justinborromeo/me-321-shaft-design/Screenshots/Top View Full Assembly.PNG

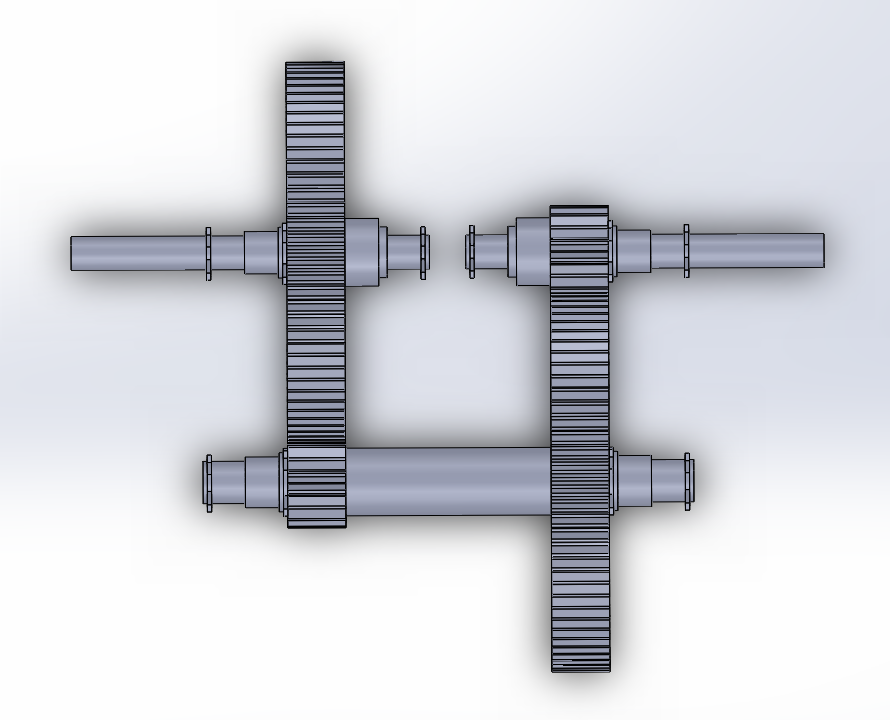
Screenshots/Top View Full Assembly.PNG
