justinborromeo/me-321-shaft-design/Screenshots/Isometric View.PNG

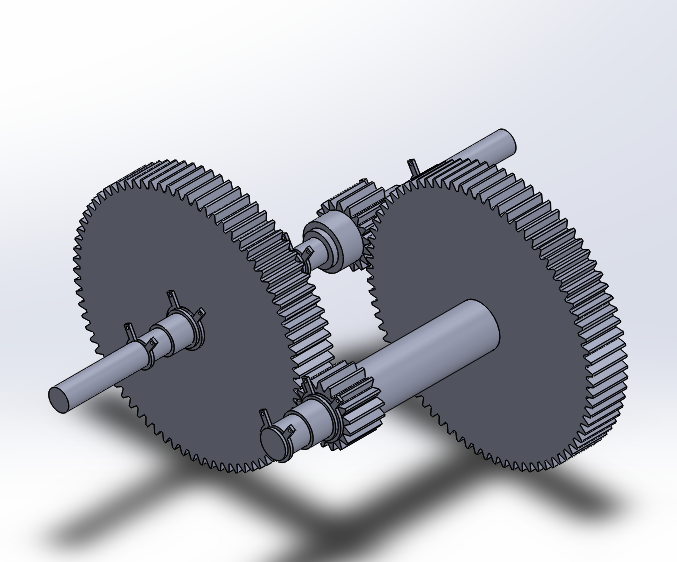
Screenshots/Isometric View.PNG
