justinborromeo/me-321-shaft-design/Screenshots/Front View Dimensions.PNG

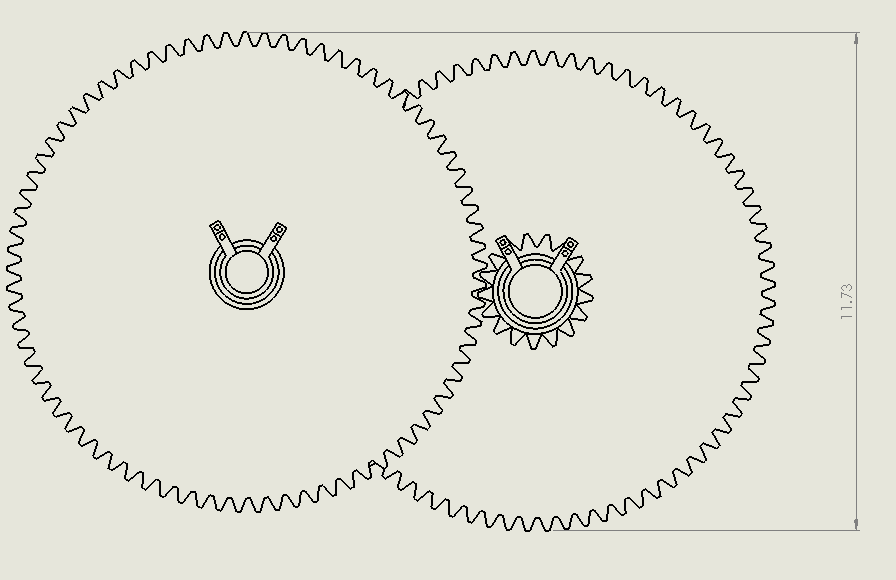
Screenshots/Front View Dimensions.PNG
