justinborromeo/me-321-shaft-design/Screenshots/Isometric View Drawing.PNG

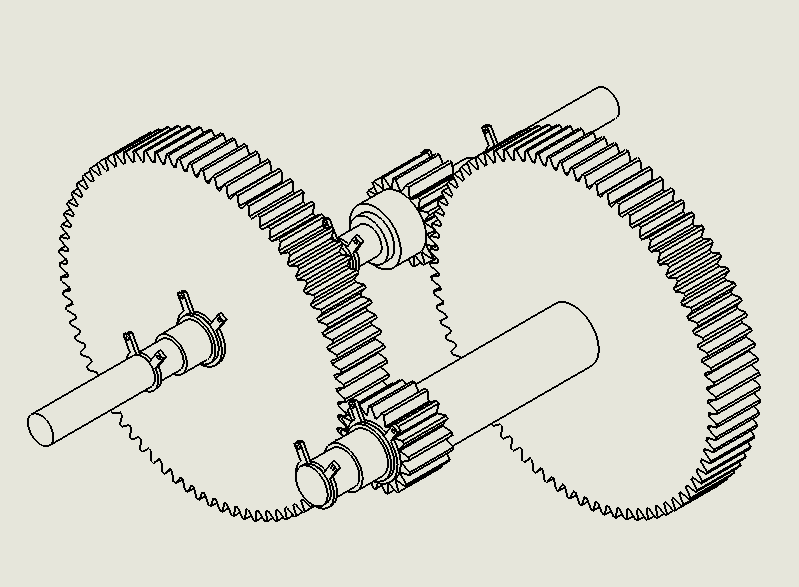
Screenshots/Isometric View Drawing.PNG
