justinborromeo/me-321-shaft-design/Screenshots/Parts/Common Keyset Drawing.PNG

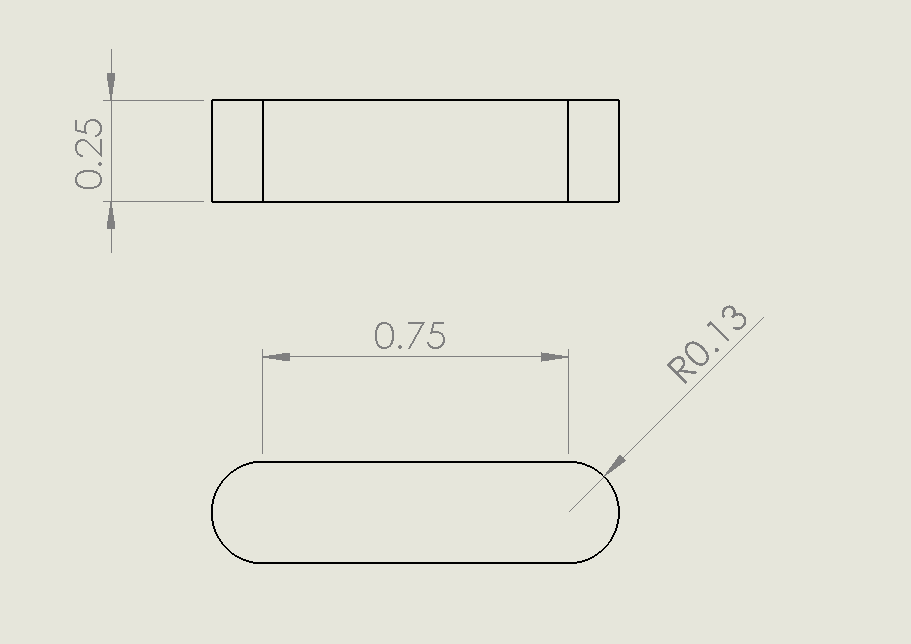
Screenshots/Parts/Common Keyset Drawing.PNG
