justinborromeo/me-321-shaft-design/Screenshots/Parts/Input Output Shafts/InputOutputShaftDrawing.PNG

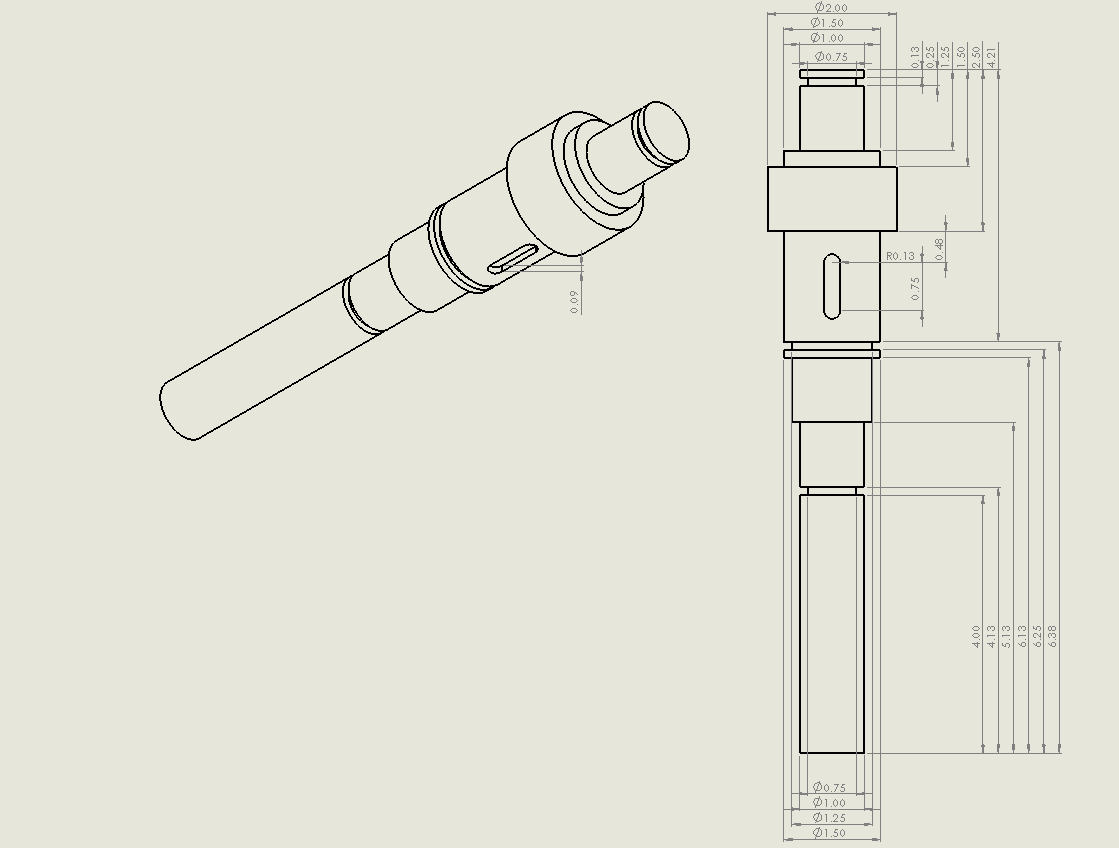
Screenshots/Parts/Input Output Shafts/InputOutputShaftDrawing.PNG
