justinborromeo/me-321-shaft-design/Screenshots/Parts/Transfer Shaft/Transfer Shaft Zoom Bottom.PNG

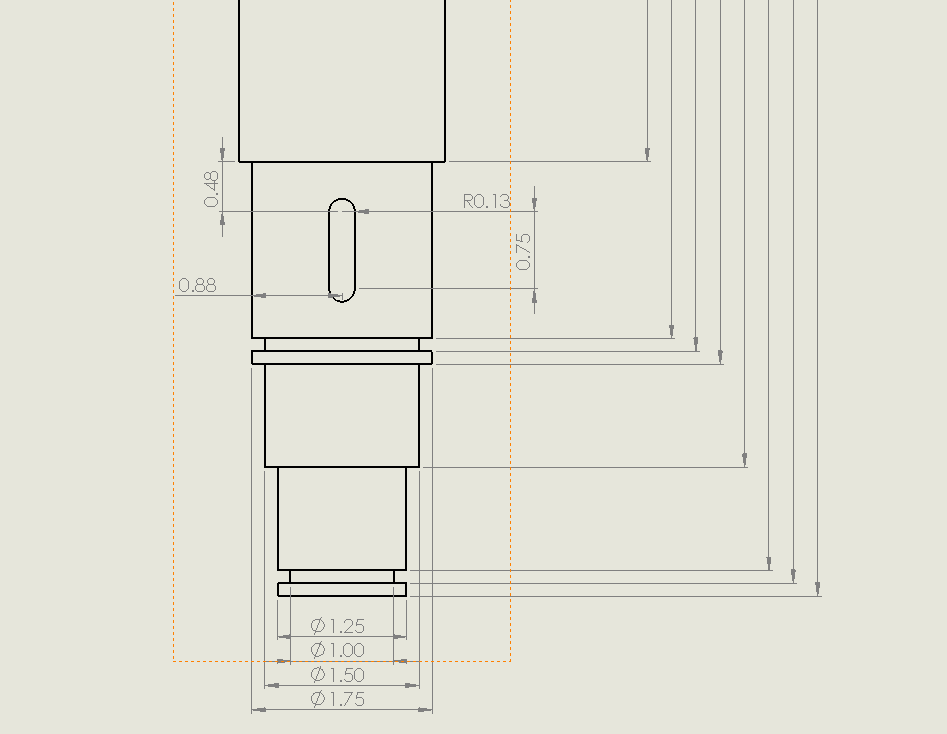
Screenshots/Parts/Transfer Shaft/Transfer Shaft Zoom Bottom.PNG
