justinborromeo/me-321-shaft-design/Screenshots/Parts/Transfer Shaft/Transfer Shaft Zoom Top.PNG

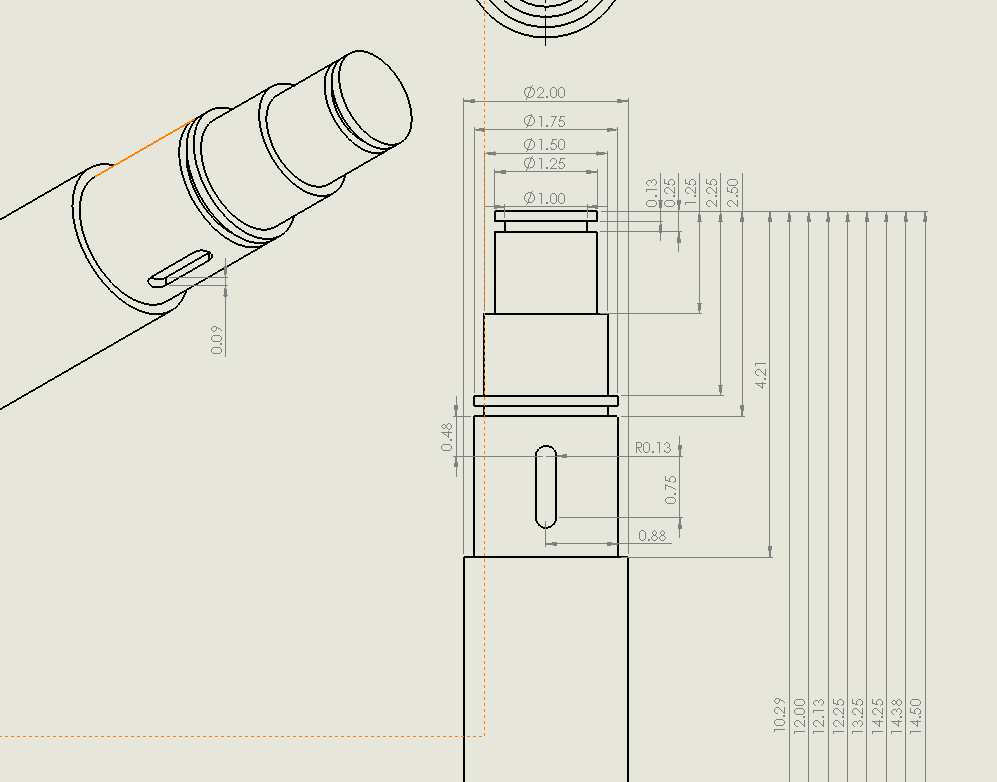
Screenshots/Parts/Transfer Shaft/Transfer Shaft Zoom Top.PNG
