justinborromeo/me-321-shaft-design/Input-Output Shaft/Input Output Shaft Assembly.SLDASM

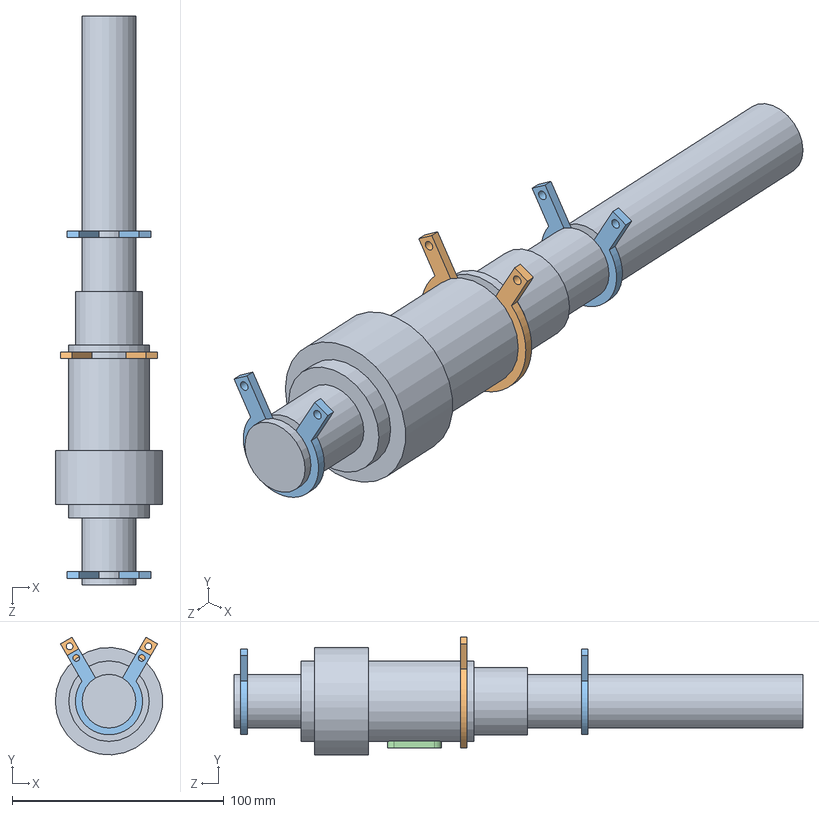
[picture p32: CAD file, 2019-07-24]
Input-Output Shaft/Input Output Shaft Assembly.SLDASM
50.8 x 55.6 x 269.0 mm
Input Output Shaft
Retaining Ring Input Output Shaft Gear
Retaining Ring Input Output Shaft Walls x 2
Keyset Common
