justinborromeo/me-321-shaft-design/InputShaftCompleteAssembly.SLDASM

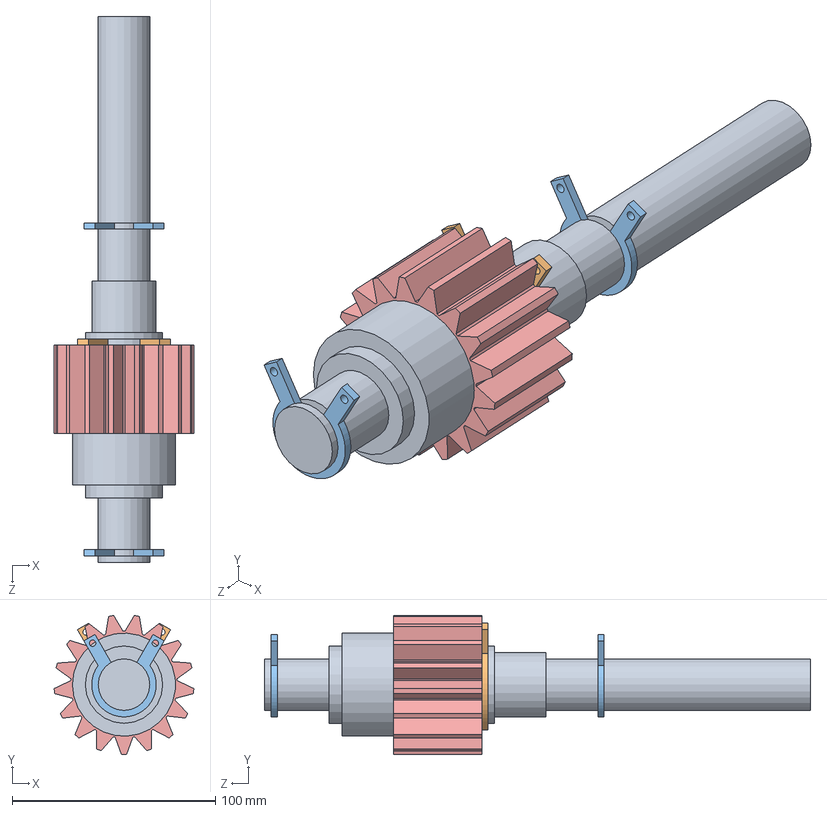
[picture p33: CAD file, 2019-07-24]
InputShaftCompleteAssembly.SLDASM
68.8 x 68.5 x 269.0 mm
Input Output Shaft
Retaining Ring Input Output Shaft Gear
Retaining Ring Input Output Shaft Walls x 2
Keyset Common
Pinion Input
