justinborromeo/me-321-shaft-design/Transfer Shaft/Transfer Shaft Assembly.SLDASM

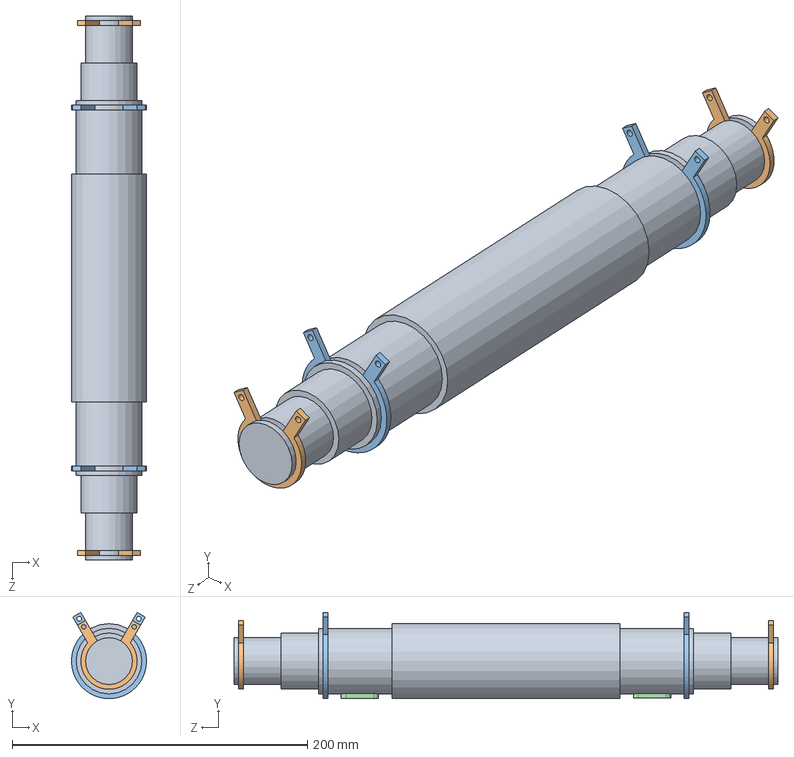
[picture p34: CAD file, 2019-07-24]
Transfer Shaft/Transfer Shaft Assembly.SLDASM
50.8 x 58.4 x 368.3 mm
Transfer Shaft
Retaining Ring Transfer Wall x 2
Retaining Ring Transfer Gears x 2
Keyset Common x 2
