justinborromeo/me-321-shaft-design/TransferShaftCompleteAssembly.SLDASM

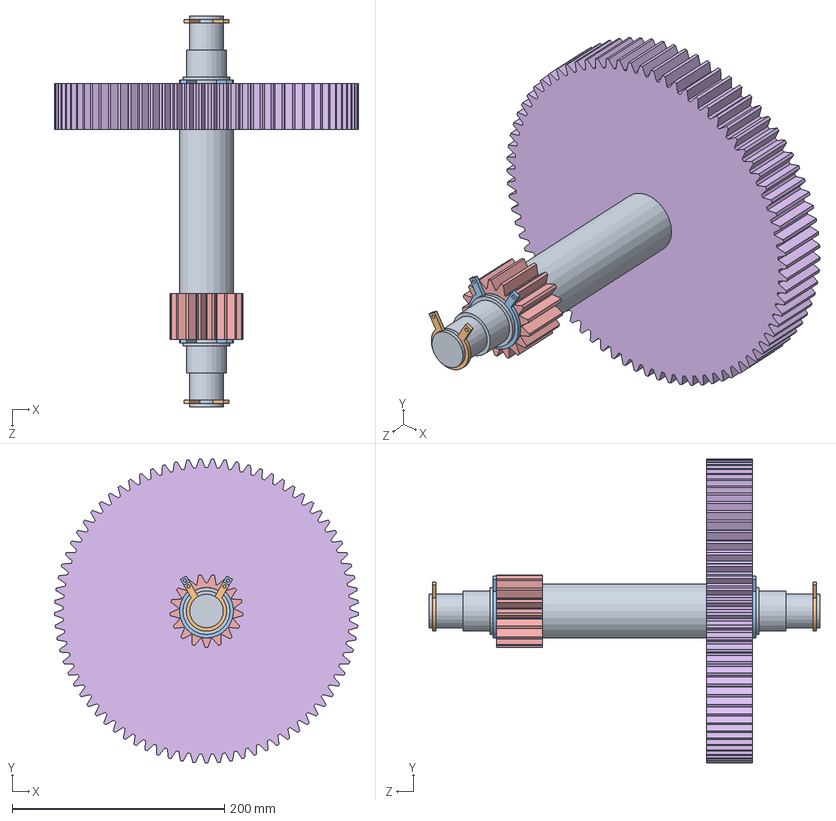
[picture p35: CAD file, 2019-07-24]
TransferShaftCompleteAssembly.SLDASM
286.6 x 286.6 x 368.3 mm
Transfer Shaft
Retaining Ring Transfer Wall x 2
Retaining Ring Transfer Gears x 2
Keyset Common x 2
Pinion Transfer
Gear Transfer
