justinborromeo/me-321-shaft-design/OutputShaftCompleteAssembly.SLDASM

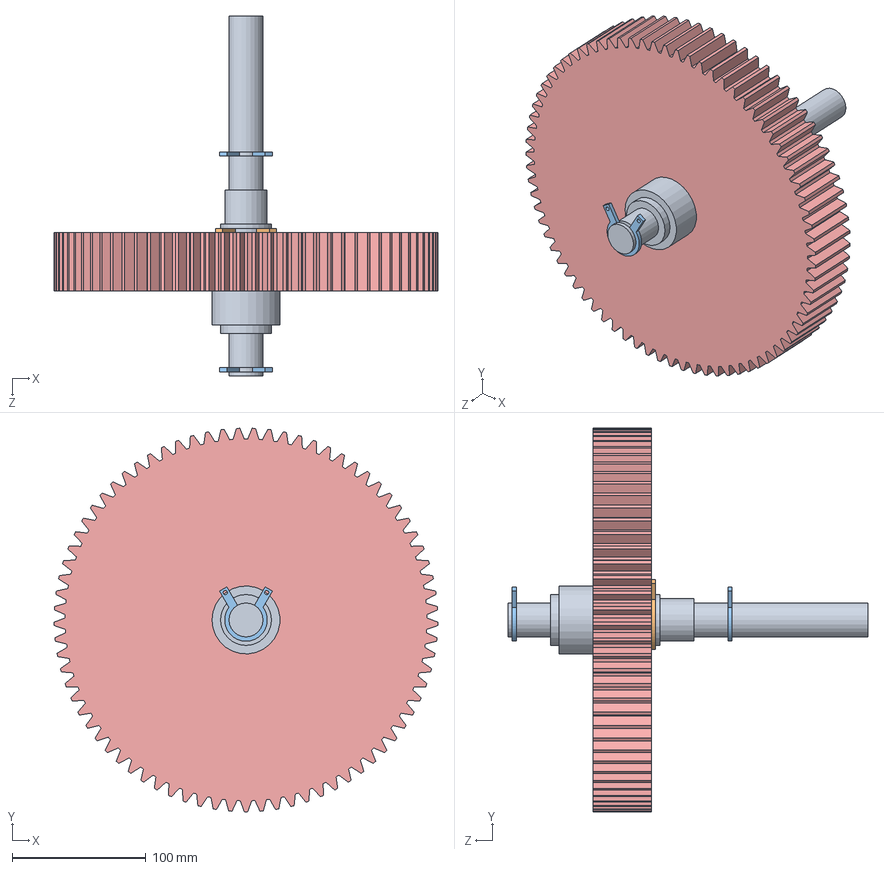
[picture p36: CAD file, 2019-07-24]
OutputShaftCompleteAssembly.SLDASM
286.6 x 286.6 x 269.0 mm
Input Output Shaft
Retaining Ring Input Output Shaft Gear
Retaining Ring Input Output Shaft Walls x 2
Keyset Common
Gear Input
