justinborromeo/me-321-shaft-design/Container/Outer Box/Outer Frame Cap.SLDPRT

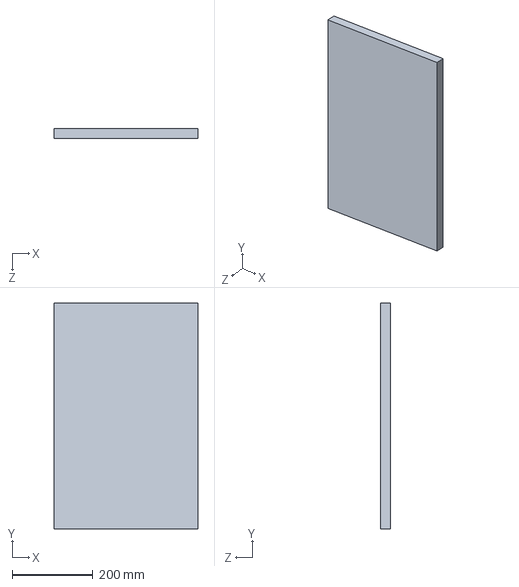
[picture p37: CAD file, 2019-07-24]
Container/Outer Box/Outer Frame Cap.SLDPRT
355.6 x 558.8 x 25.4 mm
