justinborromeo/me-321-shaft-design/Format Models/IO Shaft Format.SLDPRT

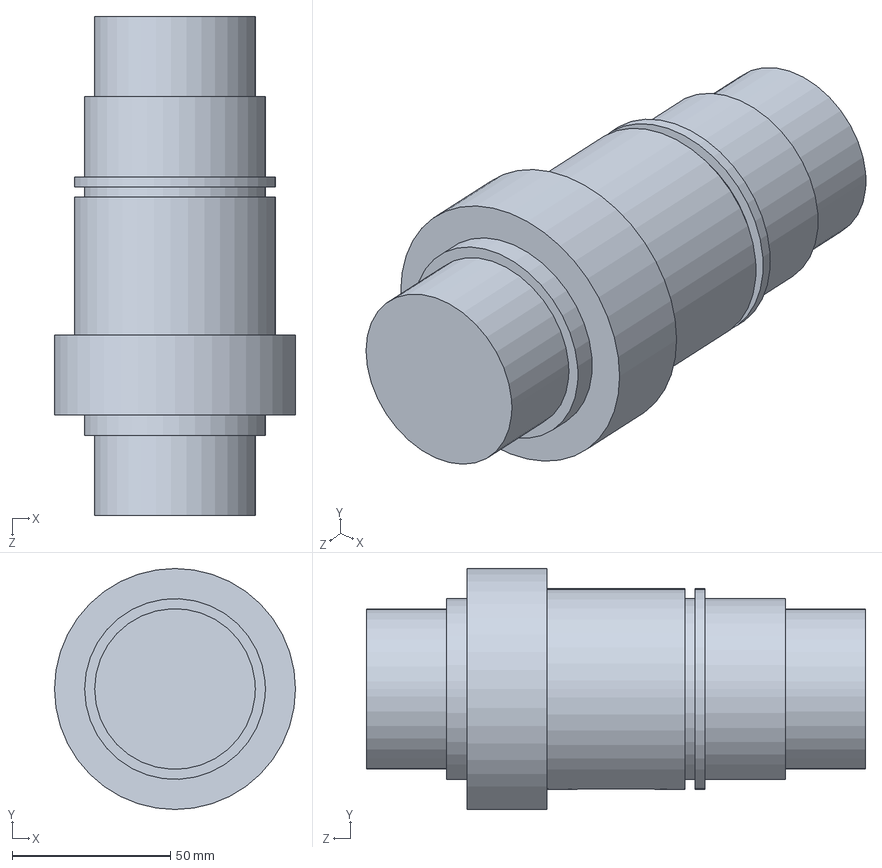
[picture p38: CAD file, 2019-07-24]
Format Models/IO Shaft Format.SLDPRT
76.2 x 76.2 x 157.8 mm
