justinborromeo/me-321-shaft-design/Container/Outer Box/Outer Box Frame.SLDPRT

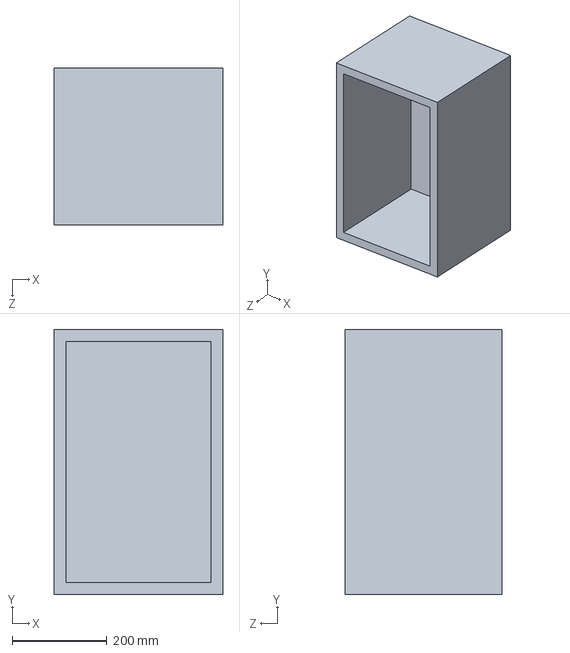
[picture p39: CAD file, 2019-07-24]
Container/Outer Box/Outer Box Frame.SLDPRT
355.6 x 558.8 x 330.2 mm
