justinborromeo/me-321-shaft-design/Format Models/Retaining Ring Format.SLDPRT

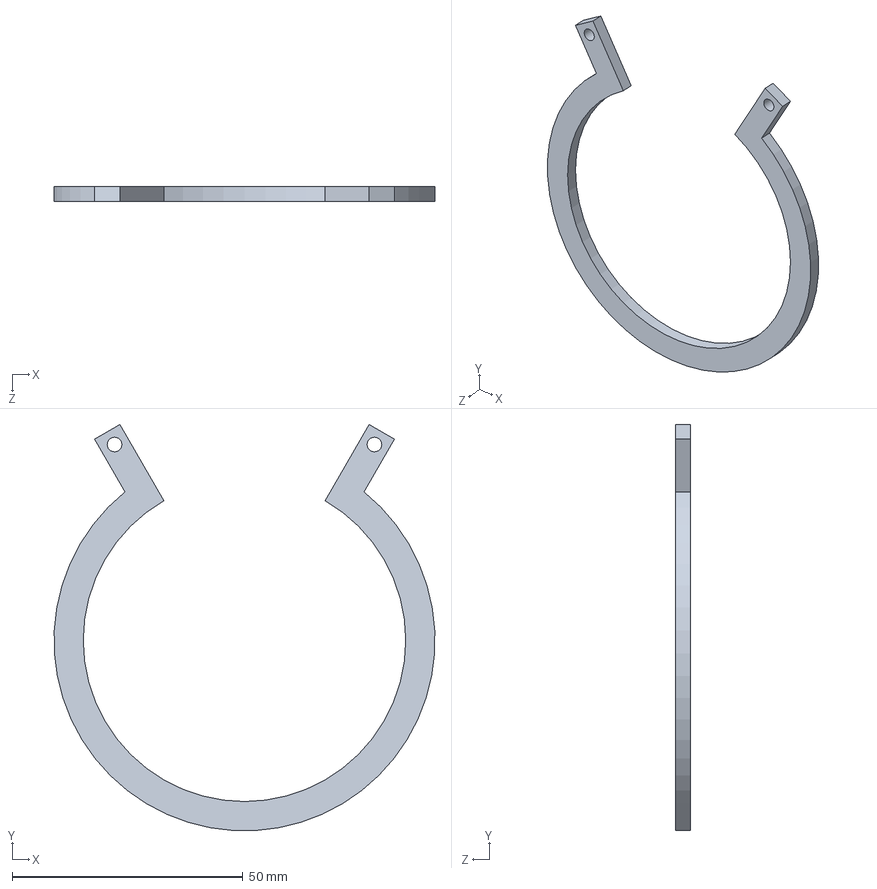
[picture p40: CAD file, 2019-07-24]
Format Models/Retaining Ring Format.SLDPRT
82.4 x 87.9 x 3.17 mm
