justinborromeo/me-321-shaft-design/Gears/Gear Input.SLDPRT

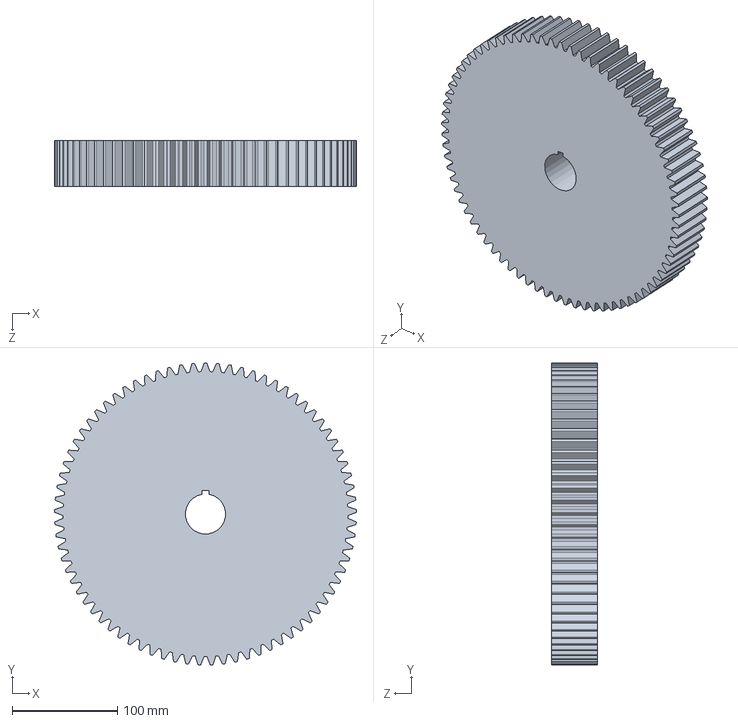
[picture p41: CAD file, 2019-07-24]
Gears/Gear Input.SLDPRT
286.6 x 286.6 x 43.5 mm
