justinborromeo/me-321-shaft-design/Input-Output Shaft/Input Output Shaft.SLDPRT

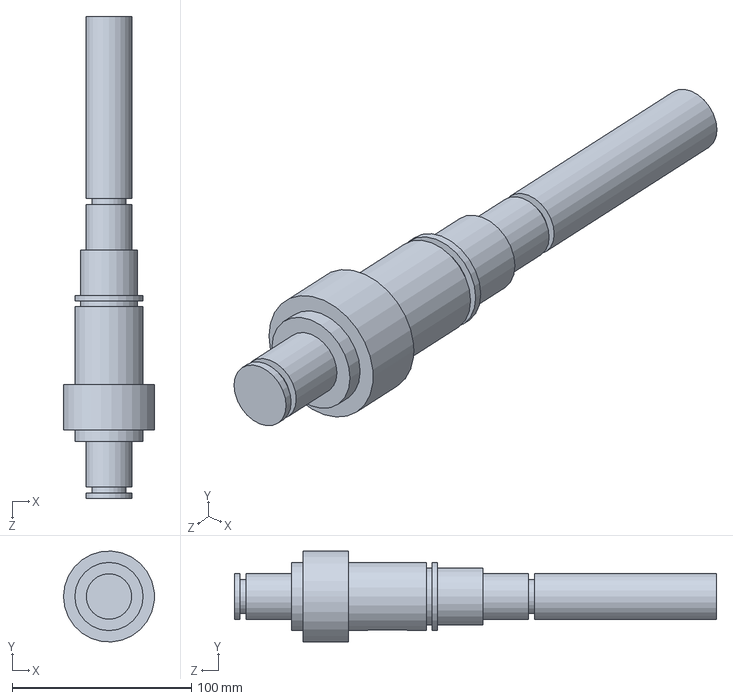
[picture p42: CAD file, 2019-07-24]
Input-Output Shaft/Input Output Shaft.SLDPRT
50.8 x 50.7 x 269.0 mm
