justinborromeo/me-321-shaft-design/Transfer Shaft/Transfer Shaft.SLDPRT

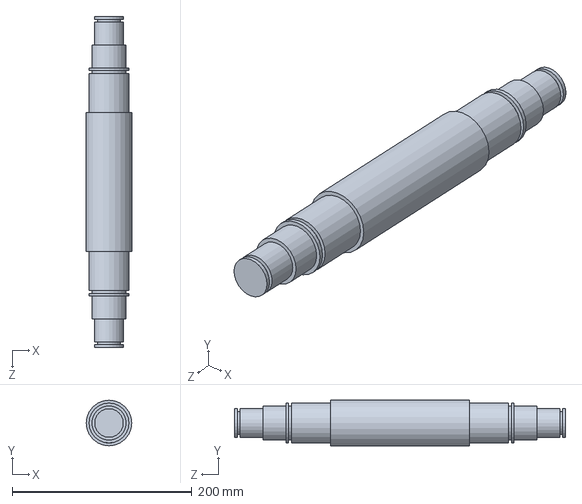
[picture p43: CAD file, 2019-07-24]
Transfer Shaft/Transfer Shaft.SLDPRT
50.8 x 50.8 x 368.3 mm
