justinborromeo/me-321-shaft-design/Input-Output Shaft/Retaining Ring Input Output Shaft Walls.SLDPRT

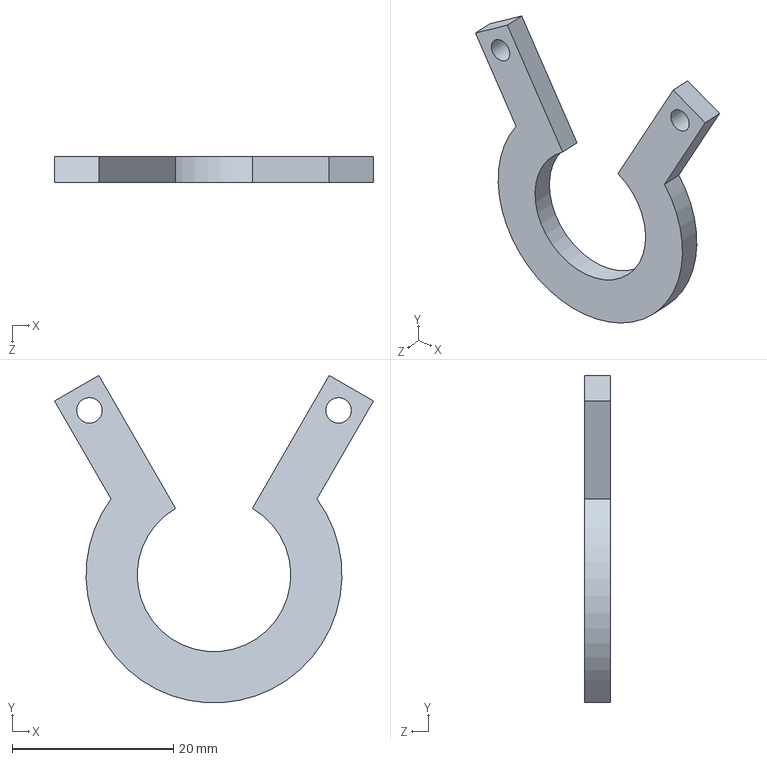
[picture p44: CAD file, 2019-07-24]
Input-Output Shaft/Retaining Ring Input Output Shaft Walls.SLDPRT
39.6 x 40.6 x 3.17 mm
