justinborromeo/me-321-shaft-design/Transfer Shaft/Retaining Ring Transfer Gears.SLDPRT

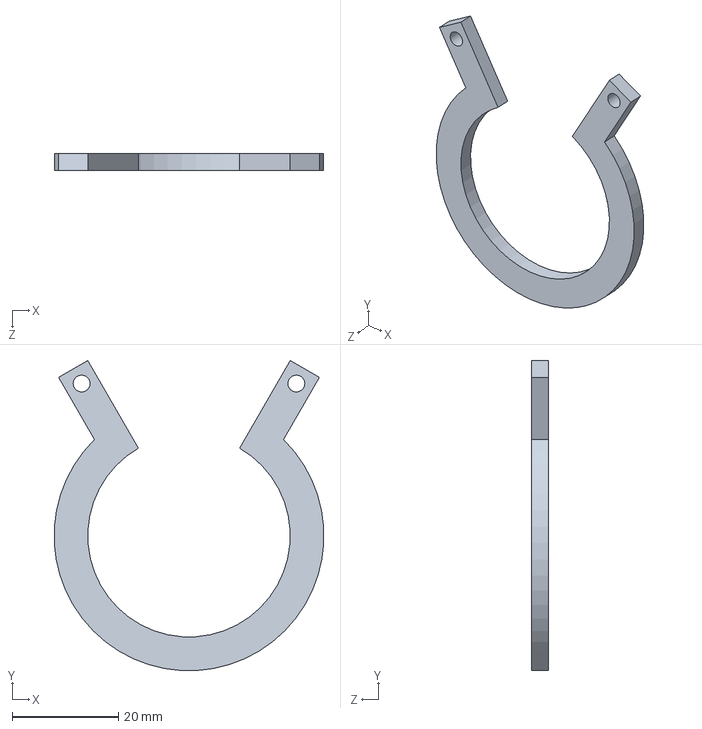
[picture p45: CAD file, 2019-07-24]
Transfer Shaft/Retaining Ring Transfer Gears.SLDPRT
50.7 x 58.3 x 3.17 mm
