justinborromeo/me-321-shaft-design/Input-Output Shaft/Retaining Ring Input Output Shaft Gear.SLDPRT

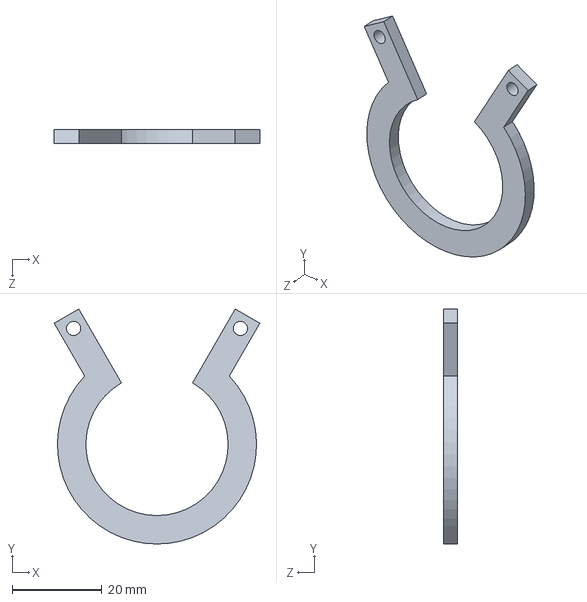
[picture p46: CAD file, 2019-07-24]
Input-Output Shaft/Retaining Ring Input Output Shaft Gear.SLDPRT
45.9 x 52.5 x 3.17 mm
