justinborromeo/me-321-shaft-design/Transfer Shaft/Retaining Ring Transfer Wall.SLDPRT

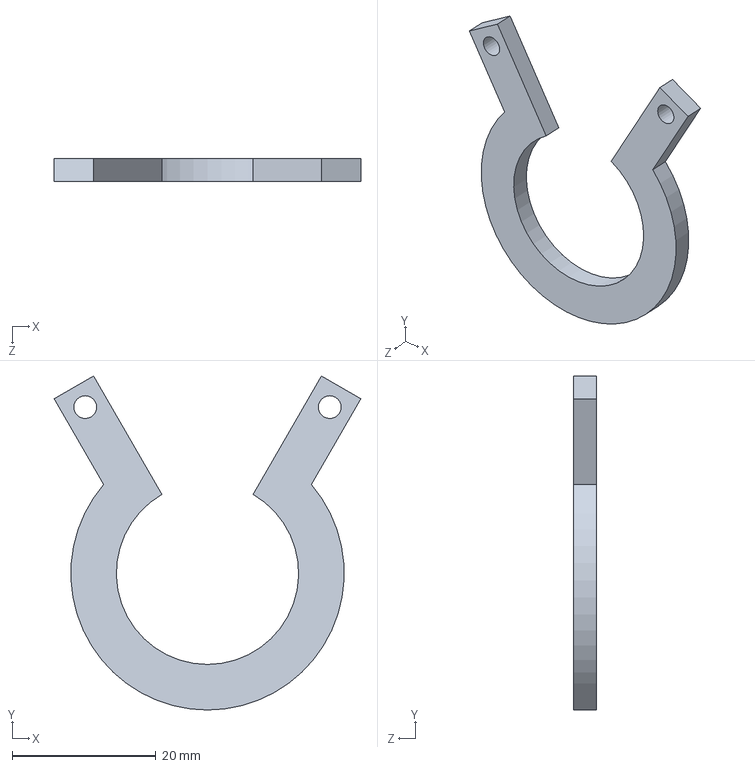
[picture p47: CAD file, 2019-07-24]
Transfer Shaft/Retaining Ring Transfer Wall.SLDPRT
42.7 x 46.5 x 3.17 mm
