justinborromeo/me-321-shaft-design/Gears/Pinion.SLDPRT

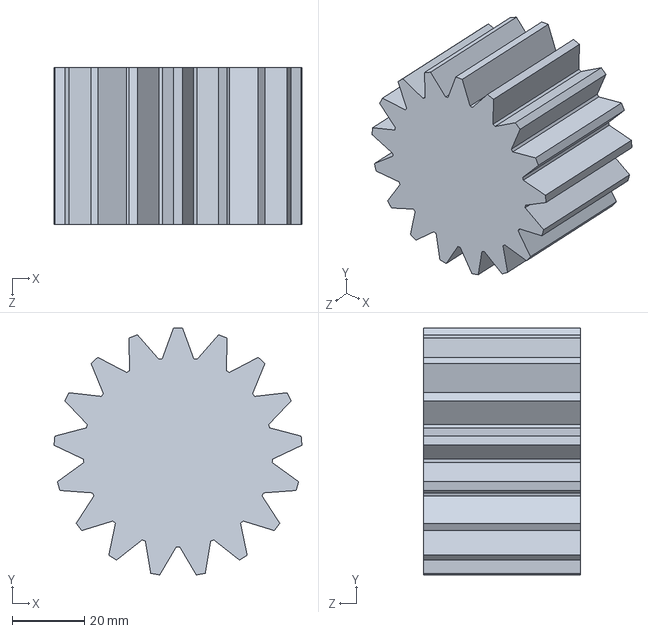
[picture p48: CAD file, 2019-07-24]
Gears/Pinion.SLDPRT
68.8 x 68.5 x 43.5 mm
