justinborromeo/me-321-shaft-design/Keyset Common.SLDPRT

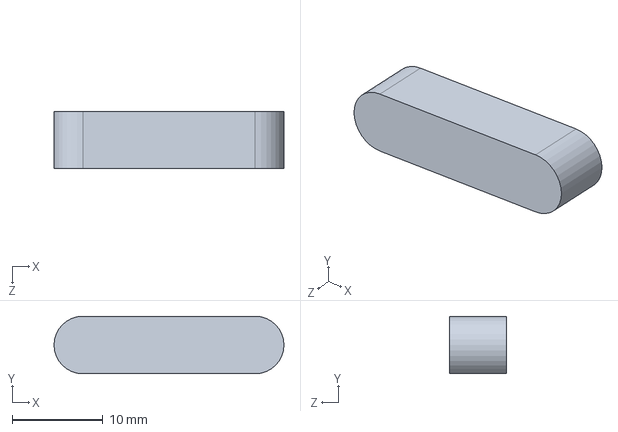
[picture p49: CAD file, 2019-07-24]
Keyset Common.SLDPRT
25.4 x 6.35 x 6.35 mm
