justinborromeo/me-321-shaft-design/Gears/Pinion Input.SLDPRT

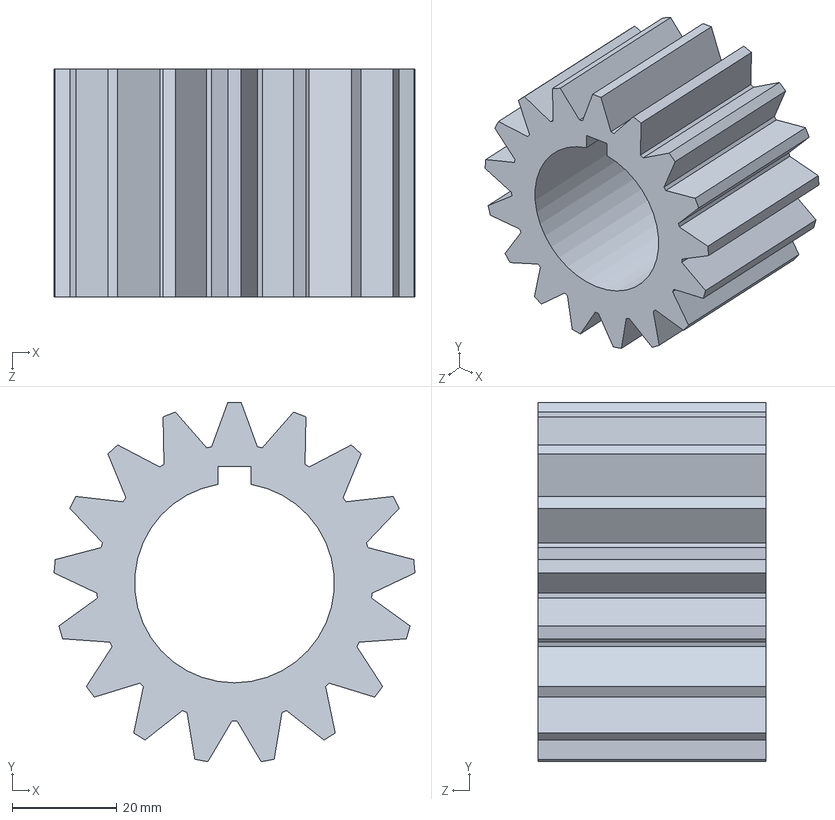
[picture p50: CAD file, 2019-07-24]
Gears/Pinion Input.SLDPRT
68.8 x 68.5 x 43.5 mm
