justinborromeo/me-321-shaft-design/(list of files, cad)

Other CAD files:
Gears/Gear Temp.SLDPRT
Gears/Gear Transfer.SLDPRT
Gears/Temp Pinion.SLDPRT
Gears/Pinion Transfer.SLDPRT
Drawings/CompleteSpeedReducerAssemblyDrawing.SLDDRW
Drawings/Input Output Shafts/Gear Output Drawing.SLDDRW
Drawings/Input Output Shafts/Input Output Shaft Drawing.SLDDRW
Drawings/Input Output Shafts/Pinion Input Drawing.SLDDRW
Drawings/Input Output Shafts/Retaining Ring Input Output Shaft Gear Drawing.SLDDRW
Drawings/Input Output Shafts/Retaining Ring Input Output Shaft Walls Drawing.SLDDRW
Drawings/Keyset Common Drawing.SLDDRW
Drawings/Transfer Shaft/Gear Transfer Drawing.SLDDRW
Drawings/Transfer Shaft/Pinion Transfer Drawing.SLDDRW
Drawings/Transfer Shaft/Retaining Ring Transfer Gears Drawing.SLDDRW
Drawings/Transfer Shaft/Retaining Ring Transfer Wall Drawing.SLDDRW
Drawings/Transfer Shaft/Transfer Shaft Drawing.SLDDRW
