justinborromeo/me-321-shaft-design/(commit log)

2019-07-16 Calcs for gear set 2
2019-07-22 Add new shafts file
2019-07-23 Shii shafts 1 and 3 are designed
2019-07-23 Added radial and tangential moment diagrams for intermediate shaft
2019-07-23 Added radial moment for internal shaft
2019-07-23 Calculated intermediate shaft diameters
2019-07-23 Improved print output for report
2019-07-24 Add solidworks and report
    [CompleteSpeedReducerAssembly.SLDASM, CompleteSpeedReducerAssemblyDrawing.SLDDRW, Gear Input.SLDPRT, Gear Output Drawing.SLDDRW, Gear Temp.SLDPRT, Gear Transfer Drawing.SLDDRW, Gear Transfer.SLDPRT, IO Shaft Format.SLDPRT]
